vladm/LEDClock/3D-Model/Clock.3mf

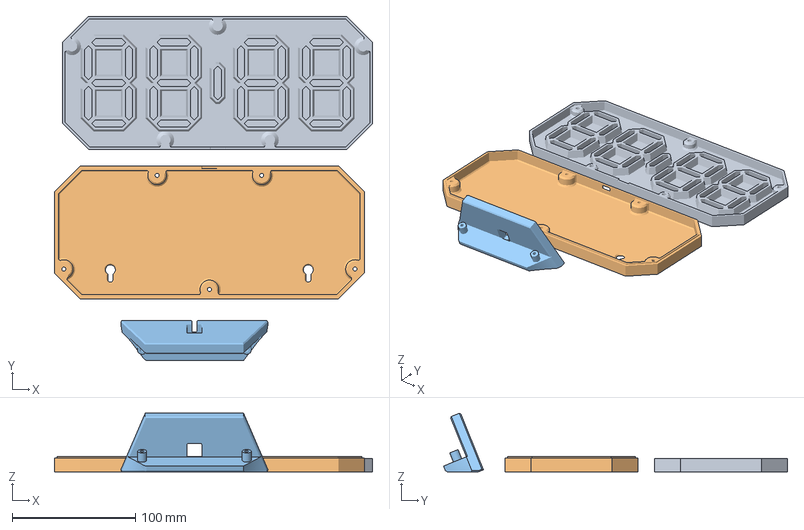
[picture p4: CAD file, 2026-11-01]
3D-Model/Clock.3mf
258.6 x 279.6 x 47.6 mm
Clock
Case
Stand
