vladm/LEDClock/media/WALL_CLOCK_SCH_Rev_B002.pdf

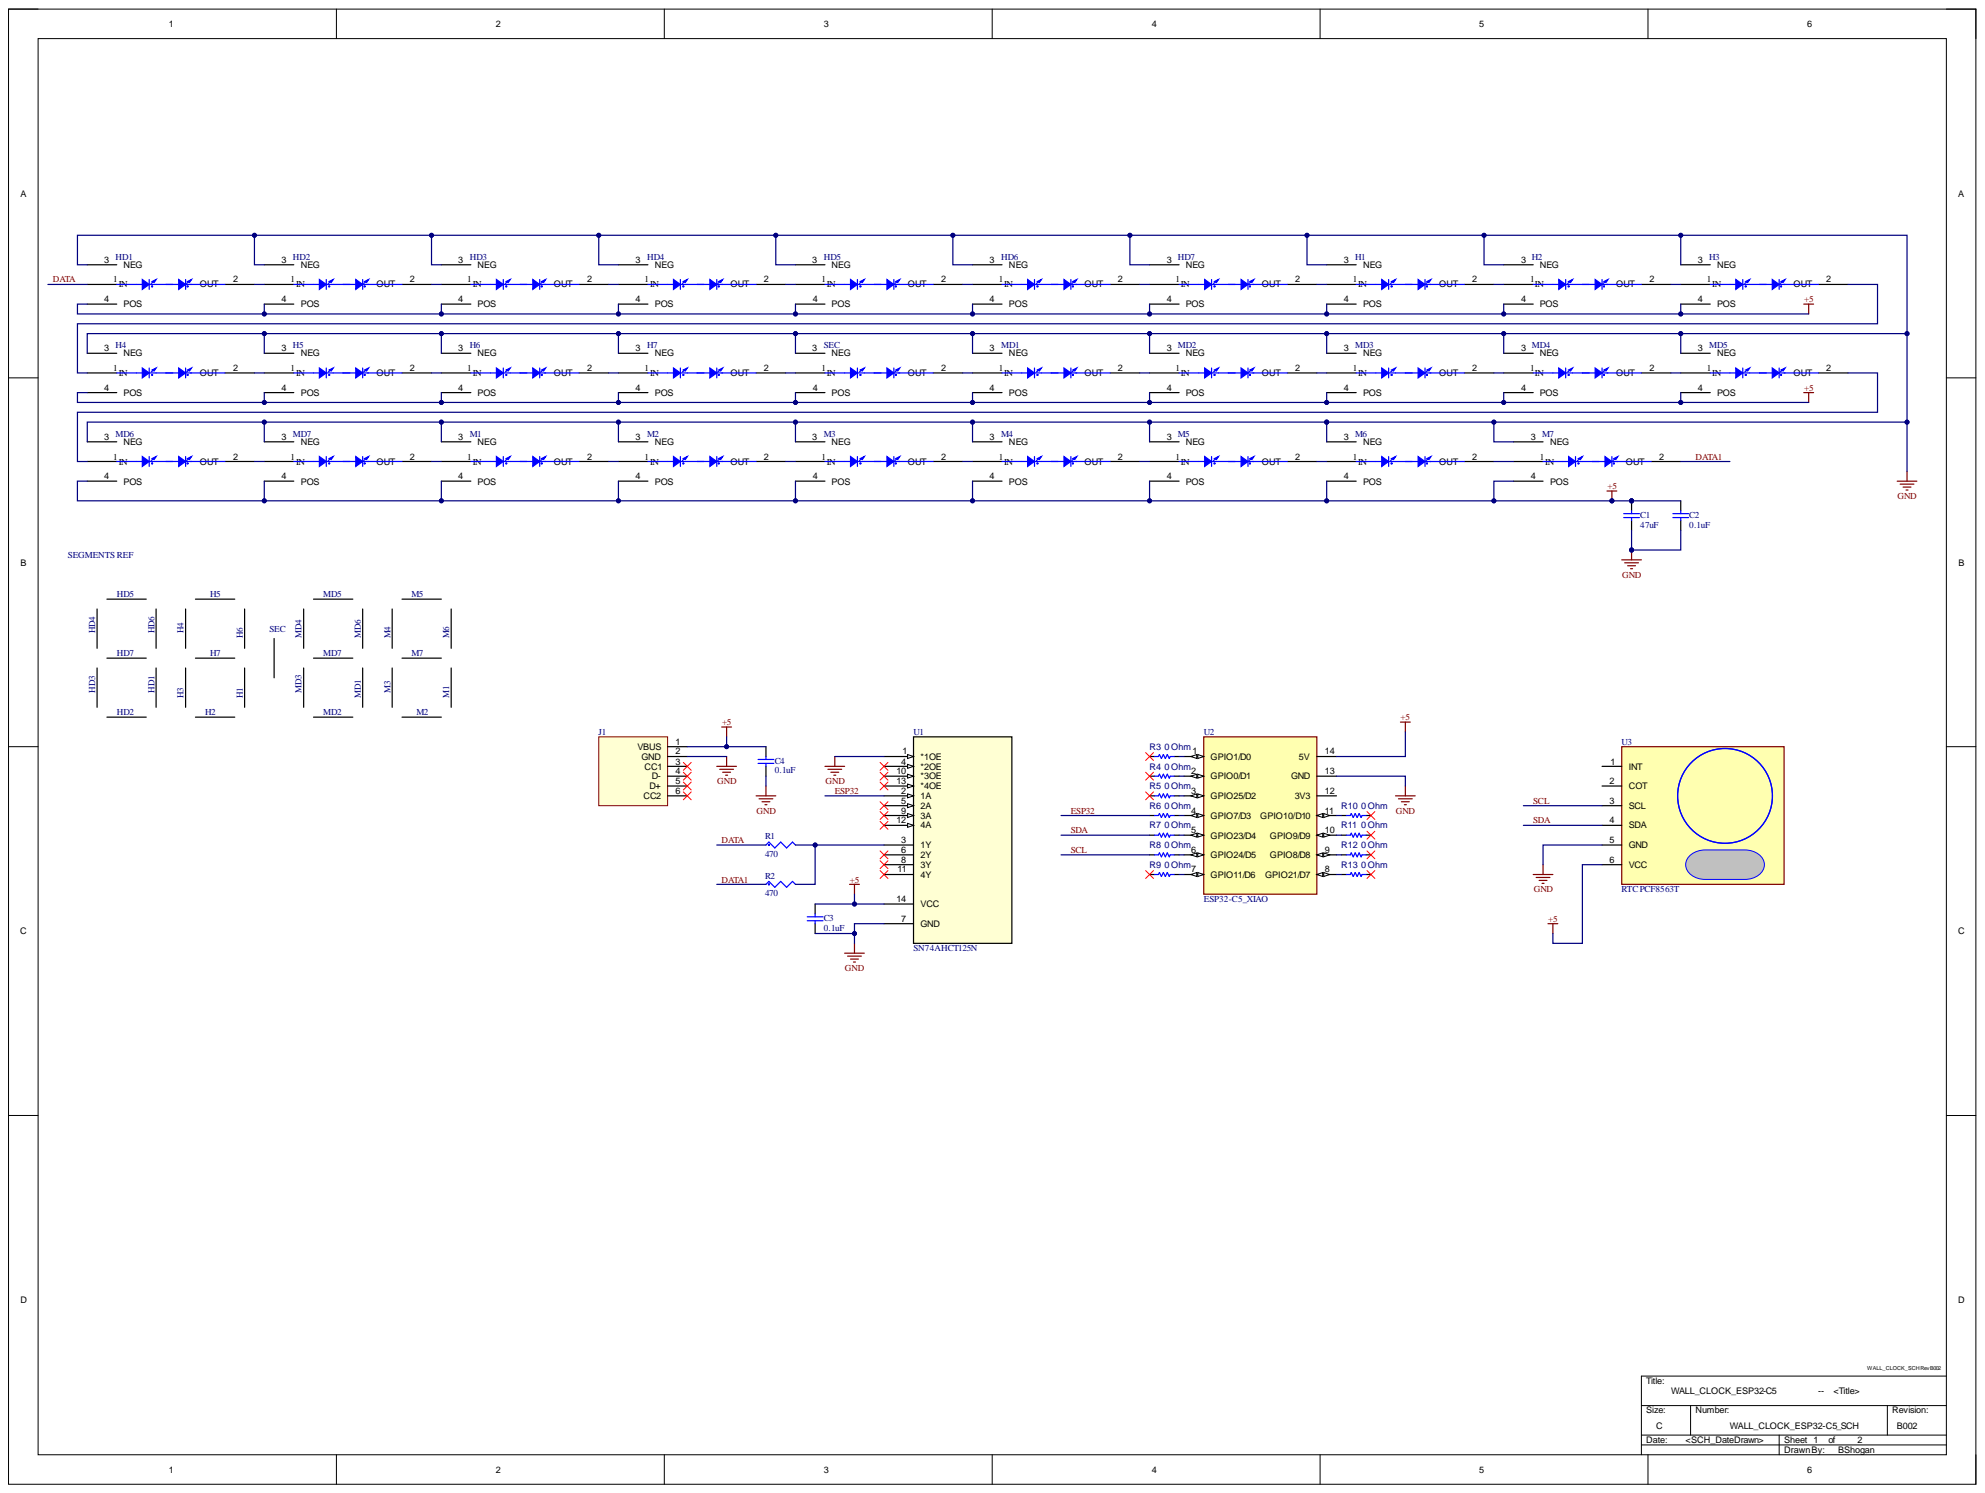
[picture p5: page 1]
