vladm/LEDClock/(commit log)

2026-11-01 LEDClock: ESPHome LED clock (CC BY-NC-SA 4.0)
    [Clock.3mf]
2026-11-06 Blank leading zero on single-digit hours; add PCB photos to README
